aln0071/Incubator/Incubator_Arduino_Sketch/Incubator_Arduino_Sketch.ino

/*
Arduino Incubator code
By: Alan Kuriakose
Date: 24th April 2020
Email: aln0071@gmail.com
Note: I have used sample code from Nathan Seidle for taking readings from the HTU21D humidity sensor.
As he says in his beerware license, we owe him a beer. ( see line 35 )
And for me, you can buy me a chocolate if we meet some day... :D

License:

    Incubator - An Arduino incubator code to control temperature and humidity
    Copyright (C) 2020  Alan Kuriakose

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
*/

/*
 HTU21D Humidity Sensor Example Code
 By: Nathan Seidle
 SparkFun Electronics
 Date: September 15th, 2013
 License: This code is public domain but you buy me a beer if you use this and we meet someday (Beerware license).

 Uses the HTU21D library to display the current humidity and temperature

 Open serial monitor at 9600 baud to see readings. Errors 998 if not sensor is detected. Error 999 if CRC is bad.

 Hardware Connections (Breakoutboard to Arduino):
 -VCC = 3.3V
 -GND = GND
 -SDA = A4 (use inline 330 ohm resistor if your board is 5V)
 -SCL = A5 (use inline 330 ohm resistor if your board is 5V)

 */

 /*
  For first 18 days
  ==================
  Temperature : 99.5 to 100 degree farenhiet = 37.5 to 37.7 degree celcius
  37.5 is ideal. Do not allow 102 degree farenheit ( 38.8 celcius ) for too long
  Let our temperature be from 37.5 to 38 degrees.

  Humidity: 50 to 55
  Let our humidity be 53 with 2 as variance

  For last 3 days
  ================
  Temperature should be little bit less than usual. It should be close to 37.5 degrees.
  Humidity should be above 65%. So, I am setting 69% to 70% humidity cutoff.

 */

#include <Wire.h>
#include "SparkFunHTU21D.h"
#include<LiquidCrystal.h>

#define FAN 7
#define HEAT 8
#define HUMIDITY 9
#define HUM_BUTTON 10
#define MODE_BUTTON 13

float thigh = 37.8;
float tlow = 37.6;
float hhigh = 52;
float hlow = 51;

int mode = 0;
String modeString = "01-17";

int Contrast=75;
LiquidCrystal lcd(12, 11, 5, 4, 3, 2);

//Create an instance of the object
HTU21D myHumidity;

void setup()
{
  analogWrite(6, Contrast);
  lcd.begin(16, 2);
  Serial.begin(9600);
  Serial.println("HTU21D Example!");

  myHumidity.begin();

  pinMode(FAN, OUTPUT);
  pinMode(HEAT, OUTPUT);
  pinMode(HUMIDITY, OUTPUT);
  pinMode(HUM_BUTTON, OUTPUT);
  pinMode(MODE_BUTTON, INPUT);
}

boolean humidifier_on = false;
boolean temperature_on = false;
int humidifier_timer = 0;

// Function to turn on fan and humidifier
void turnOnHumidifier() {
  digitalWrite(FAN, HIGH);
  digitalWrite(HUMIDITY, HIGH);
  humidifier_on = true;
  humidifier_timer = 0; // reset humidifier timer
}

// Function to push humidifier button
void pushHumidifierButton() {
  digitalWrite(HUM_BUTTON, HIGH);
  delay(500);
  digitalWrite(HUM_BUTTON, LOW);
  delay(500); // this is to make the delay to a constant 1 second
  updateAllTimers();
}

// Function to update timers to compensate the 1 second loss
void updateAllTimers() {
  // put some code here that will update all timers by 1 second
  // to compensate the 1 second loss due to humidifier's push button press
}

// Function to turn off fan and humidifier
void turnOffHumidifier() {
  // turn off fan only if heater/light is also off
  if(temperature_on == false) {
    digitalWrite(FAN, LOW);
  }
  digitalWrite(HUMIDITY, LOW);
  humidifier_on = false;
  humidifier_timer = 0; // reset humidifier timer
}

// Function to turn on light and fan
void turnOnTemperature() {
  digitalWrite(HEAT, HIGH);
  digitalWrite(FAN, HIGH);
  temperature_on = true;
}

// Function to turn off light and fan
void turnOffTemperature() {
  // turn off fan only if humidifier is also off
  if(humidifier_on == false) {
    digitalWrite(FAN, LOW);
  }
  digitalWrite(HEAT, LOW);
  temperature_on = false;
}

// function to change mode
void setMode(int newMode) {
  if(newMode == mode) {
    return;
  }
  switch(newMode) {
    case 0:
      thigh = 37.8;
      tlow = 37.6;
      hhigh = 52;
      hlow = 51;
      modeString="01-17";
      break;
    case 1:
      thigh = 37.6;
      tlow = 37.5;
      hhigh = 70;
      hlow = 69;
      modeString="18-21";
      break;
  }
  mode = newMode;
}

void loop()
{
  float humd = myHumidity.readHumidity();
  float temp = myHumidity.readTemperature();

  // configuration for mode 2 - days 18-20;
  int newMode = digitalRead(MODE_BUTTON);
  setMode(newMode);

  lcd.clear();
  lcd.setCursor(0, 0);
  lcd.print("Hum:");
  lcd.print(humd);
  lcd.setCursor(0, 1);
  lcd.print("Temp:");
  lcd.print(temp);
  lcd.setCursor(11,0);
  lcd.print("Days");
  lcd.setCursor(11,1);
  lcd.print(modeString);

  Serial.print("Time:");
  Serial.print(millis());
  Serial.print(" Temperature:");
  Serial.print(temp, 1);
  Serial.print("C");
  Serial.print(" Humidity:");
  Serial.print(humd, 1);
  Serial.print("%");

  /********* HUMIDITY SECTION ***********/

  // count humidifier timer
  if(humidifier_on == true) {
    humidifier_timer++;
  }

  // push humidifier button after 2 seconds
  if(humidifier_timer == 2) {
    pushHumidifierButton();
  }

  // after 30 seconds, give the humidifier a rest; this will still cause the timer to run
  if(humidifier_timer == 30) {
    digitalWrite(HUMIDITY, LOW);
  }

  // turn on the humidifier after a 1 second rest - in effect gives 4 second break
  if(humidifier_timer > 31) {
    turnOnHumidifier();
  }

  // turn on fan and humidifier
  if(humd <= hlow) {
    if(humidifier_on == false) {
      turnOnHumidifier();
    }
  }

  // turn off fan and humidifier
  if(humd >= hhigh) {
    if(humidifier_on == true) {
      turnOffHumidifier();
    }
  }

  /******************************************/

  /********* TEMPERATURE SECTION ***********/

  // increase temperature if it is low
  if(temp <= tlow && temperature_on == false) {
    turnOnTemperature();
  }

  // turn off light and fan if temperature has reached higher limit
  if(temp >= thigh && temperature_on == true) {
    turnOffTemperature();
  }

  /******************************************/

  Serial.println();
  delay(1000);
}
